TZeys/BimmerScreenFS/docs/hardware/schematic.md

# Wiring

Block level. This is five modules on a piece of prototype board. A PCB and proper schematics are
being drawn up, and this page will be replaced when they exist.

Full pin tables are in [pinout.md](pinout.md). The car side connector is documented in
[headunit-connector-a42x1b.jpg](headunit-connector-a42x1b.jpg).

```mermaid
flowchart LR
    subgraph CAR["Headunit connector A42x1B"]
        P15["pin 15
        12V, sleeps ~30 min
        after locking"]
        P12["pin 12
        GND"]
        P11["pin 11
        CAN HIGH"]
        P9["pin 9
        CAN LOW"]
    end

    FUSE["inline fuse
    1 to 2 A"]
    BUCK["LM2596
    12V to 5.0V"]

    subgraph ESP["ESP32-C3 SuperMini"]
        V5["5V"]
        V33["3V3"]
        G3["GPIO3"]
        G5["GPIO5"]
        G1["GPIO1"]
        G4["GPIO4"]
        G6["GPIO6"]
        G8["GPIO8"]
        G20["GPIO20"]
        G21["GPIO21"]
    end

    CAN["SN65HVD230
    transceiver"]
    TFT["ILI9341
    2.8in 320x240"]
    MP3["DFPlayer Mini"]
    SPK["speaker"]

    P15 --> FUSE --> BUCK
    P12 --> BUCK
    BUCK -->|5V| V5
    BUCK -->|5V| MP3

    P11 -->|CANH| CAN
    P9  -->|CANL| CAN
    CAN -->|RX| G3
    G5  -->|TX| CAN
    V33 -->|3.3V| CAN

    G4 -->|SCK| TFT
    G6 -->|MOSI| TFT
    G8 -->|CS| TFT
    G1 -->|DC| TFT
    V33 -->|3.3V + LED + RST| TFT

    G21 -->|1k series| MP3
    MP3 -->|TX| G20
    MP3 --> SPK
```
## KiCAD Schematic



## Grounds

Everything shares one ground, and that ground is the car's, taken from pin 12 of the headunit
connector. The transceiver needs the same reference the car uses or CANH and CANL sit at the wrong
common mode voltage and the bus goes deaf.

Do not run a separate chassis ground alongside pin 12. Two ground paths of different lengths is how
you get a loop, and on a CAN tap that shows up as intermittent frame errors that are miserable to
chase.

## Fusing

Pin 15 is fused at 20A because that fuse exists to protect the head unit's wiring, not a 250 mA
display. Put a 1 to 2 A inline fuse in the tap, as close to the connector as the loom allows. A
short in the module without one means a 20A fuse holding happily while the thin wire you added
becomes the fuse. I personally did not use one, but I recommend doing so. _Do as I say, not as I do_

## Power and standby

Pin 15 on the BMW F22 Headunit seems to be tapped to ACC power. The rail comes up when the car is unlocked and drops about 30
minutes after it is locked, because BMW's energy management sleeps the head unit's supply rather
than feeding it continuously.

That turns out to be exactly what this build wants, and it is why there is no sleep code in the
firmware:

- Unlock the car and the display boots on its own.
- Ignition off runs the shutdown sound and the CRT collapse, then blanks the screen. The rail is
  still live at that point, so the animation actually gets to finish instead of being cut off
  mid-frame.
- Half an hour or so after locking, the rail drops and the module goes off with it.

So there is no parasitic drain to design around. The module does stay awake through that half hour
with the backlight lit behind a black screen, which is wasted current, but it is bounded and the
car decides when it ends. Driving the backlight from a GPIO through a transistor would tidy that up
and is the only reason to bother.

**This depends entirely on the rail you tap.** If you find a genuinely permanent 12V feed instead,
none of the above holds: nothing in the firmware sleeps, the backlight is hardwired to 3.3V, and you
will flatten the battery over a couple of weeks. Confirm what your rail actually does, by leaving
the car locked and measuring, before you trust it.

## Tapping the bus

Pins 9 and 11 at the headunit connector are the pair I used. Reaching them means pulling the head
unit, which on the F22 is trim clips and a few screws. Takes 3 minutes with some practice. 

I would rather solder and heatshrink onto the back of the connector than use a piercing tap. A
piercing tap on a twisted CAN pair _CAN_ break the twist at the junction and lets the stub radiate, and
it eventually corrodes. Impedance matching, signal reflections yada yada yada. I _did_ use taps, but when doing so, 
keep tap short, twisted and as close to the termination as possible. Try to match wire guage as well!

Keep the stub short. A tap on a 500 kbit/s bus is an unterminated branch, and long branches reflect.
Mine is about 10 cm from connector to transceiver. Keep CANH and CANL twisted together right up to
the transceiver pins.
