TZeys/BimmerScreenFS/docs/hardware/headunit-connector-a42x1b.jpg

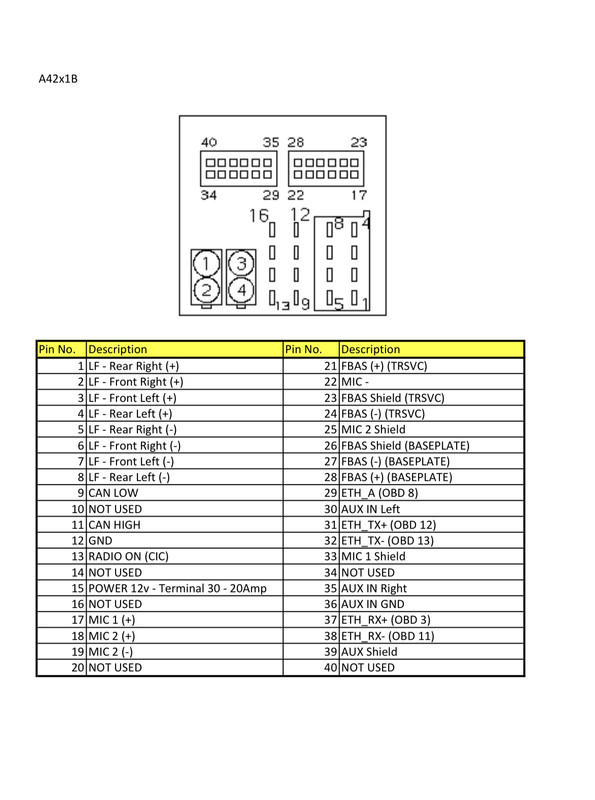
docs/hardware/headunit-connector-a42x1b.jpg
