TZeys/BimmerScreenFS/(commit log)

2026-07-30 document the hardware: BOM, pinout and wiring
2026-07-30 confirm the DFPlayer 5V rail, the speaker and the microSD naming
2026-07-30 add the build photo and note the PCB work in progress
2026-07-30 correct the 12V rail: it sleeps after locking, so there is no standby drain
